Rezzonics/NuTubeAmp/NuTubeAmp_1_0_MS_tube_MouserOrder.txt

642-GH36P010001|2
81-GRM39X104K50D|2
81-GRM188R71C474KA88|2
667-ERJ-2GE0R00X|2
667-ERJ-6GEY0R00V|1
81-GRM21BR6YA106KE3L|1
667-ERJ-2GE0R00X|2
667-ERJ-2RKF1004X|16
667-ERJ-3EKF1001V|1
810-C1608X5R1H105K|18
667-ERJ-PA3F2201V|1
667-ERJ-2RKF4701X|2
667-ERJ-2RKF4701X|1
71-CRCW060310R0FKEAH|3
652-CR0603-FX1002HLF|2
667-ERJ-2RKF1002X|2
81-GRM21BR6YA106KE3L|16
652-SRN4018-100M|1
*|1 *** ERROR : V1
667-ERJ-3EKF2002V|2
810-C2012X5R1V226MAC|1
502-35RAPC4BHN2|1
81-GRM155R71H473KE4D|1
667-EEE-HBC470UAR|2
667-ERJ-2RKF5602X|1
875-HI0805R800R-10|2
667-ERJ-2RKF8202X|1
667-ERJ-3EKF8202V|3
667-ERJ-2RKF1000X|4
667-EEE-1VA101XP|2
667-ERJ-2RKF1003X|7
667-ERJ-3EKF1003V|3
667-EEE-1VA101XP|2
652-SRN1060-101M|1
81-GRM188R71C184KA1D|1
81-GRM155C1H271JA01D|1
667-ERJ-PA3F3000V|1
667-ERJ-2GEJ434X|1
81-GRM1885C1H102FA1D|6
696-SSL-LX5093GD|1
696-SSL-LX5093USBD|1
652-3314G-1-105E|1
652-3310Y-001-102L|1
652-3310Y-001-103L|1
652-3314G-2-103E|2
652-3310H-001-104L|1
652-3310Y-001-204L|2
652-3310Y-001-504L|2
81-BLM31PG121SN1L|1
642-MHS122K|1
642-MHS122K|1
490-PJ-202A|1
*|3 *** ERROR : JP3/JP4/JP5
926-LME49723MA/NOPB|1
534-1249|4
512-MMBF4117|10
550-12202|3
*|2 *** ERROR : H1/H3
*|4 *** ERROR : H2/H4/H6/H7
652-3314G-1-504E|2
810-C1608X5R1H105K|4
667-ERJ-2RKF1002X|2
667-ERJ-3EKF2400V|2
81-GRM21BR6YA106KE3L|2
*|1 *** ERROR : U1
595-TPA3112D1PWP|1
595-TPA6111A2D|1
595-TPS62175DQCR|1
*|22 *** ERROR : TP1/TP2/TP3/TP4/TP5/TP6/TP7/TP8/TP9/TP10/TP11/TP12/TP13/TP14/TP15/TP16/TP17/TP18/TP19/TP20/TP21/TP22
649-77311-401-36LF|1
649-77311-401-36LF|1
