Rezzonics/NuTubeAmp/NuTubeAmp_1_0_1.brd

## EAGLE design NuTubeAmp_1_0_1.brd (2018-03-24)

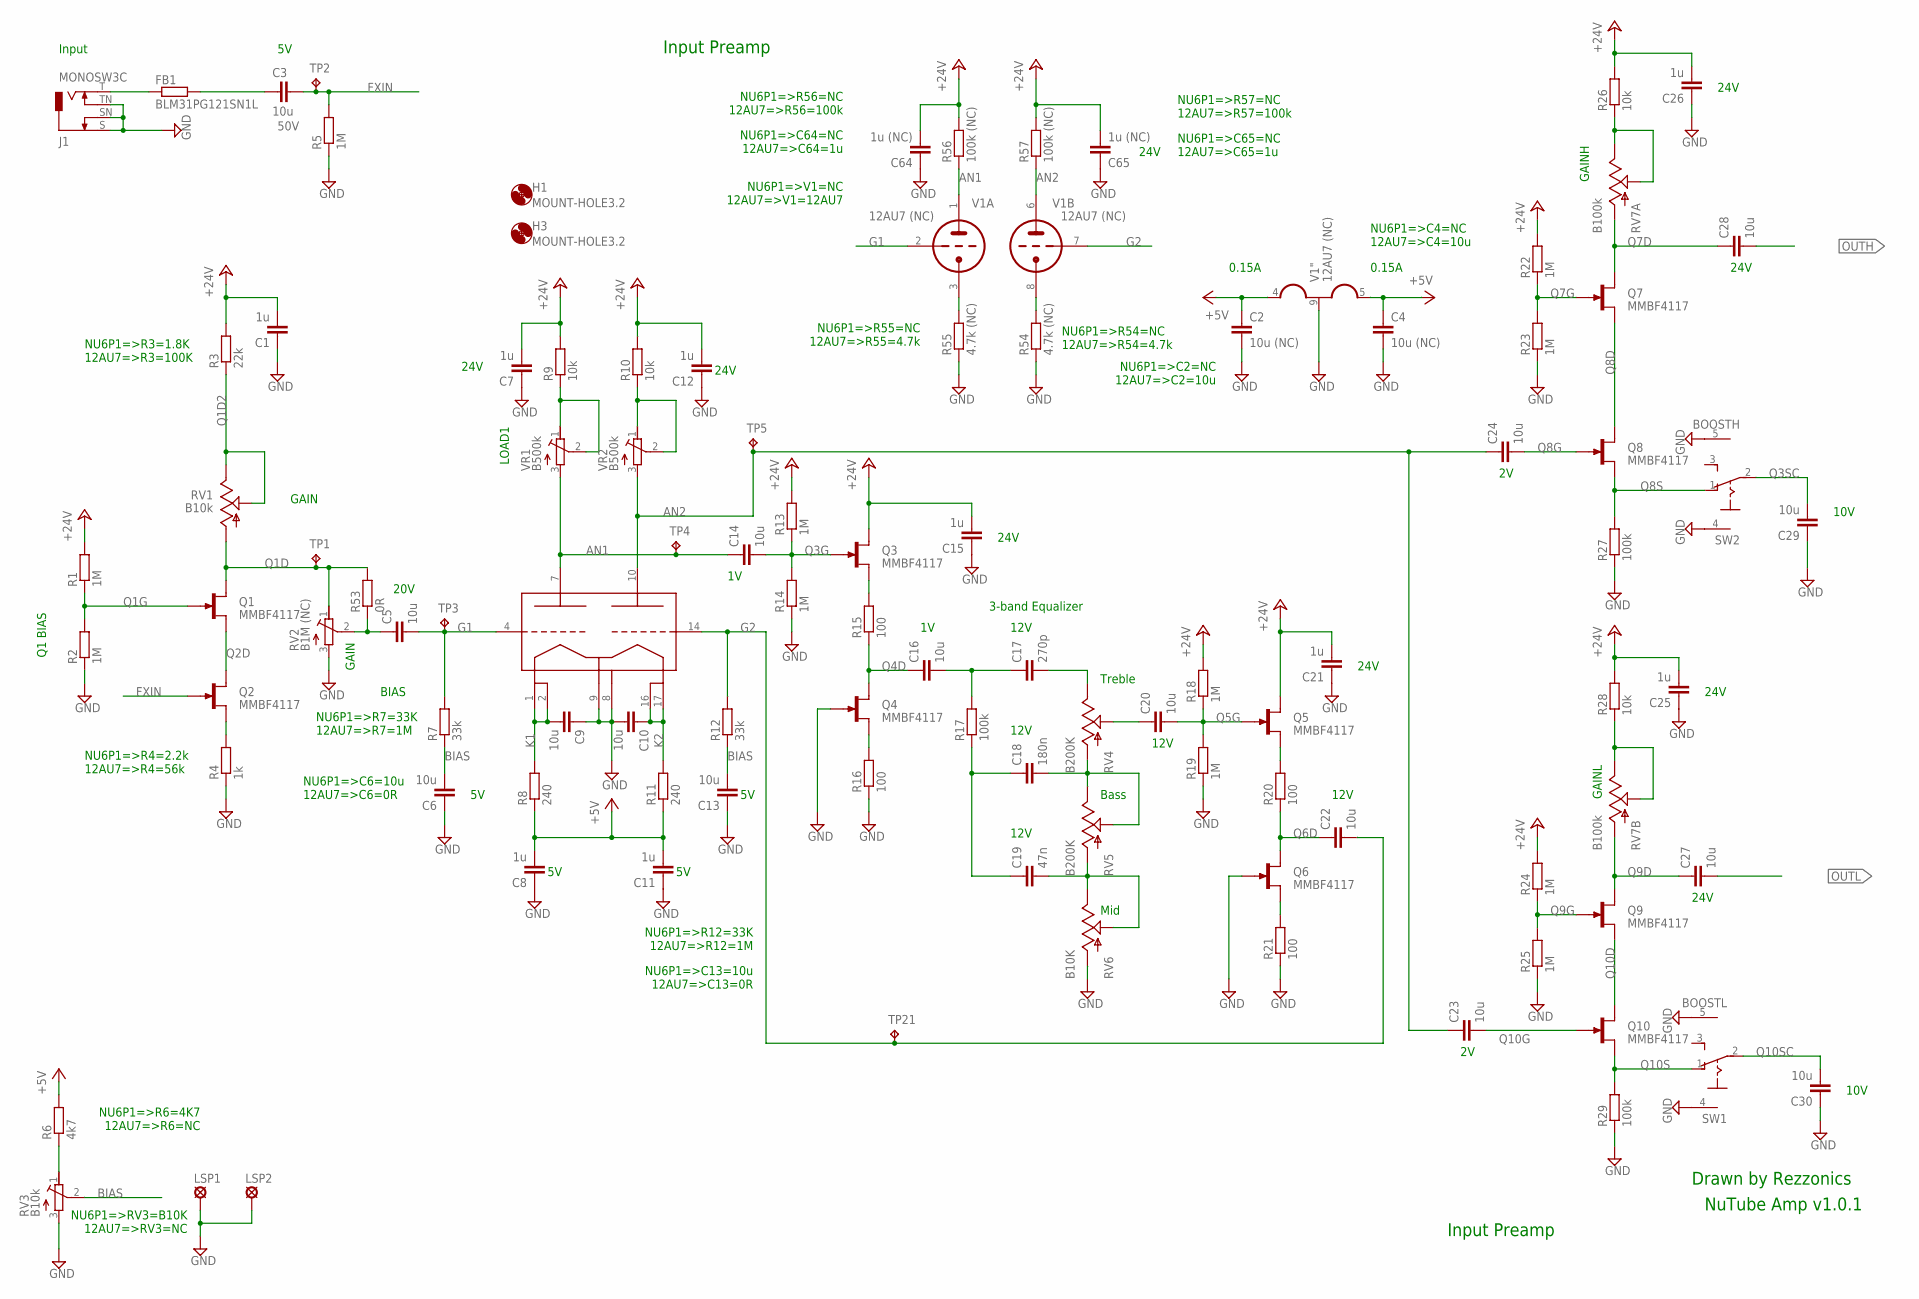
[picture p1: schematic NuTubeAmp_1_0_1.sch, sheet 1]

Parts:
C1, C7, C8, C11, C12, C15, C21, C25, C26: 1u; C0603K; MPN C1608X5R1H105K080AB
C2, C4: 10u (NC); C0805K; MPN GRM21BR6YA106KE43L
C3, C5, C6, C9, C10, C13, C14, C16, C20, C22, C23, C24, C27, C28, C29, C30: 10u; C0805K; MPN GRM21BR6YA106KE43L
C17: 270p; C0402K; MPN GRM1555C1H271JA01D
C18: 180n; C0603K; MPN GRM188R71C184KA01D
C19: 47n; C0402K; MPN GRM155R71H473KE14D
C64, C65: 1u (NC); C0603K; MPN C1608X5R1H105K080AB
FB1: BLM31PG121SN1L; R1206; MPN BLM31PG121SN1L
H1, H3: MOUNT-HOLE3.2; 3,2; MPN *
J1: MONOSW3C; NEUTRIK-NMJ4HCD2; MPN NMJ4HCD2
LSP1, LSP2: LSP13; MPN 1249
Q1, Q2, Q3, Q4, Q5, Q6, Q7, Q8, Q9, Q10: MMBF4117; SOT23; MPN MMBF4117
R1, R2, R5, R13, R14, R18, R19, R22, R23, R24, R25: 1M; R0402; MPN ERJ-2RKF1004X
R3: 22k; R0402; MPN ERJ-2RKF1801X
R4: 1k; R0402; MPN ERJ-2RKF2201X
R6: 4k7; R0402; MPN ERJ-2RKF4701X
R7, R12: 33k; R0402; MPN ERJ-2RKF3302X
R8, R11: 240; R0603; MPN ERJ-3EKF2400V
R9, R10, R26, R28: 10k; R0402; MPN ERJ-2RKF1002X
R15, R16, R20, R21: 100; R0402; MPN ERJ-2RKF1000X
R17, R27, R29: 100k; R0402; MPN ERJ-2RKF1003X
R53: 0R; R0402; MPN ERJ-2GE0R00X
R54, R55: 4.7k (NC); R0402; MPN ERJ-2RKF4701X
R56, R57: 100k (NC); R0402; MPN ERJ-2RKF1003X
RV1: B10k; 3310Y; MPN 3310Y-001-103L
RV2: B1M (NC); RTRIM3314G; MPN 3314G-1-105E
RV3: B10k; RTRIM3314G; MPN 3314G-2-103E
RV4, RV5: B200K; 3310Y; MPN 3310Y-001-204L
RV6: B10K; 3310Y; MPN 3310Y-001-103L
RV7: B100k; 3310H; MPN 3310H-001-104L
SW1: BOOSTL; MHS122K; MPN MHS122K
SW2: BOOSTH; MHS122K; MPN MHS122K
TP1, TP2, TP3, TP4, TP5, TP21: TPTP10R; TP10R; MPN *
U1: NUTUBE 6P1; NUTUBE_6P1_1; MPN *
V1: 12AU7 (NC); VT9; MPN *
VR1, VR2: B500k; RTRIM3314G; MPN 3314G-1-504E

Connections:
+5V: C2.1, C4.1, C8.2, C11.2, R6.2, R8.1, R11.1, V1.4 (H1), V1.5 (H3); also elsewhere on the board
+24V: C1.2, C7.2, C12.2, C15.2, C21.2, C25.2, C26.2, C64.2, C65.2, Q3.1 (D), Q5.1 (D), R1.2, R3.2, R9.2, R10.2, R13.2, R18.2, R22.2, R24.2, R26.2, R28.2, R56.2, R57.2; also elsewhere on the board
AN1: C14.1, R56.1, TP4.TP, U1.7 (A1_7), V1.1 (TA), VR1.3 (A)
AN2: C23.1, C24.1, R57.1, TP5.TP, U1.10 (A2_10), V1.6 (TA), VR2.3 (A)
BAST: C18.2, RV4.P$1 (A), RV5.P$2 (S), RV5.P$3 (E)
BIAS: C6.2, C13.2, R7.1, R12.1, RV3.2 (S)
EQIN: C16.2, C17.1, R17.2
EQOUT: C20.1, RV4.P$2 (S)
FXIN: C3.2, Q2.2 (G), R5.2, TP2.TP
G1: C5.2, R7.2, TP3.TP, U1.4 (G1_4), V1.2 (TG)
G2: C22.2, R12.2, TP21.TP, U1.14 (G2_14), V1.7 (TG)
G2TOP: R55.2, V1.3 (TK)
G3TOP: R26.1, RV7.P$2 (S), RV7.P$3 (E)
G4TOP: R28.1, RV7.P$5 (S), RV7.P$6 (E)
GND: C1.1, C2.2, C4.2, C6.1, C7.1, C8.1, C9.1, C10.2, C11.1, C12.1, C13.1, C15.1, C21.1, C25.1, C26.1, C29.1, C30.1, C64.1, C65.1, J1.S, J1.SN, J1.TN, LSP1.MP, LSP2.MP, Q4.2 (G), Q6.2 (G), R2.1, R4.1, R5.1, R14.1, R16.1, R19.1, R21.1, R23.1, R25.1, R27.1, R29.1, R54.1, R55.1, RV2.3 (A), RV3.3 (A), RV6.P$1 (A), SW1.4 (G1), SW1.5 (G2), SW2.4 (G1), SW2.5 (G2), U1.8 (GND_8), U1.9 (F2_9), V1.9 (H2); also elsewhere on the board
GTOP: C5.1, R53.1, RV2.2 (S)
K1: C9.2, R8.2, U1.1 (F1_1), U1.2 (F1_2)
K2: C10.1, R11.2, U1.16 (F3_16), U1.17 (F3_17)
MIDT: C19.2, RV5.P$1 (A), RV6.P$2 (S), RV6.P$3 (E)
unnamed: FB1.1, J1.T
unnamed: C3.1, FB1.2
unnamed: Q3.3 (S), R15.2
unnamed: R6.1, RV3.1 (E)
unnamed: R54.2, V1.8 (TK)
unnamed: C18.1, C19.1, R17.1
OUTH: C28.2; also elsewhere on the board
OUTL: C27.2; also elsewhere on the board
Q1D: Q1.1 (D), R53.2, RV1.P$1 (A), RV2.1 (E), TP1.TP
Q1D2: R3.1, RV1.P$2 (S), RV1.P$3 (E)
Q1G: Q1.2 (G), R1.1, R2.2
Q1S: Q2.3 (S), R4.2
Q1S1: Q4.3 (S), R16.2
Q1S2: Q6.3 (S), R21.2
Q2D: Q1.3 (S), Q2.1 (D)
Q3G: C14.2, Q3.2 (G), R13.1, R14.2
Q3SC: C29.2, SW2.2
Q4D: C16.1, Q4.1 (D), R15.1
Q5G: C20.2, Q5.2 (G), R18.1, R19.2
Q5S: Q5.3 (S), R20.2
Q6D: C22.1, Q6.1 (D), R20.1
Q7D: C28.1, Q7.1 (D), RV7.P$1 (A)
Q7G: Q7.2 (G), R22.1, R23.2
Q8D: Q7.3 (S), Q8.1 (D)
Q8G: C24.2, Q8.2 (G)
Q8S: Q8.3 (S), R27.2, SW2.1 (O)
Q9D: C27.1, Q9.1 (D), RV7.P$4 (A)
Q9G: Q9.2 (G), R24.1, R25.2
Q10D: Q9.3 (S), Q10.1 (D)
Q10G: C23.2, Q10.2 (G)
Q10S: Q10.3 (S), R29.2, SW1.1 (O)
Q10SC: C30.2, SW1.2
RL1: R9.1, VR1.1 (E), VR1.2 (S)
RL2: R10.1, VR2.1 (E), VR2.2 (S)
TBT: C17.2, RV4.P$3 (E)

Notes on the sheet:
NuTube Amp v1.0.1
Drawn by Rezzonics
Input Preamp
Treble
3-band Equalizer
Bass
Input
GAIN
Q1 BIAS
Mid
20V
24V
12V
10V
LOAD1
GAINH
GAINL
NU6P1=>R7=33K 12AU7=>R7=1M
BIAS
0.15A
NU6P1=>R3=1.8K 12AU7=>R3=100K
NU6P1=>R4=2.2k 12AU7=>R4=56k
NU6P1=>C6=10u 12AU7=>C6=0R
NU6P1=>V1=NC 12AU7=>V1=12AU7
NU6P1=>C64=NC 12AU7=>C64=1u
NU6P1=>R56=NC 12AU7=>R56=100k
NU6P1=>R57=NC 12AU7=>R57=100k
NU6P1=>C65=NC 12AU7=>C65=1u
NU6P1=>R55=NC 12AU7=>R55=4.7k
NU6P1=>R54=NC 12AU7=>R54=4.7k
NU6P1=>C2=NC 12AU7=>C2=10u
NU6P1=>C4=NC 12AU7=>C4=10u
NU6P1=>R12=33K 12AU7=>R12=1M
NU6P1=>C13=10u 12AU7=>C13=0R
NU6P1=>R6=4K7 12AU7=>R6=NC
NU6P1=>RV3=B10K 12AU7=>RV3=NC

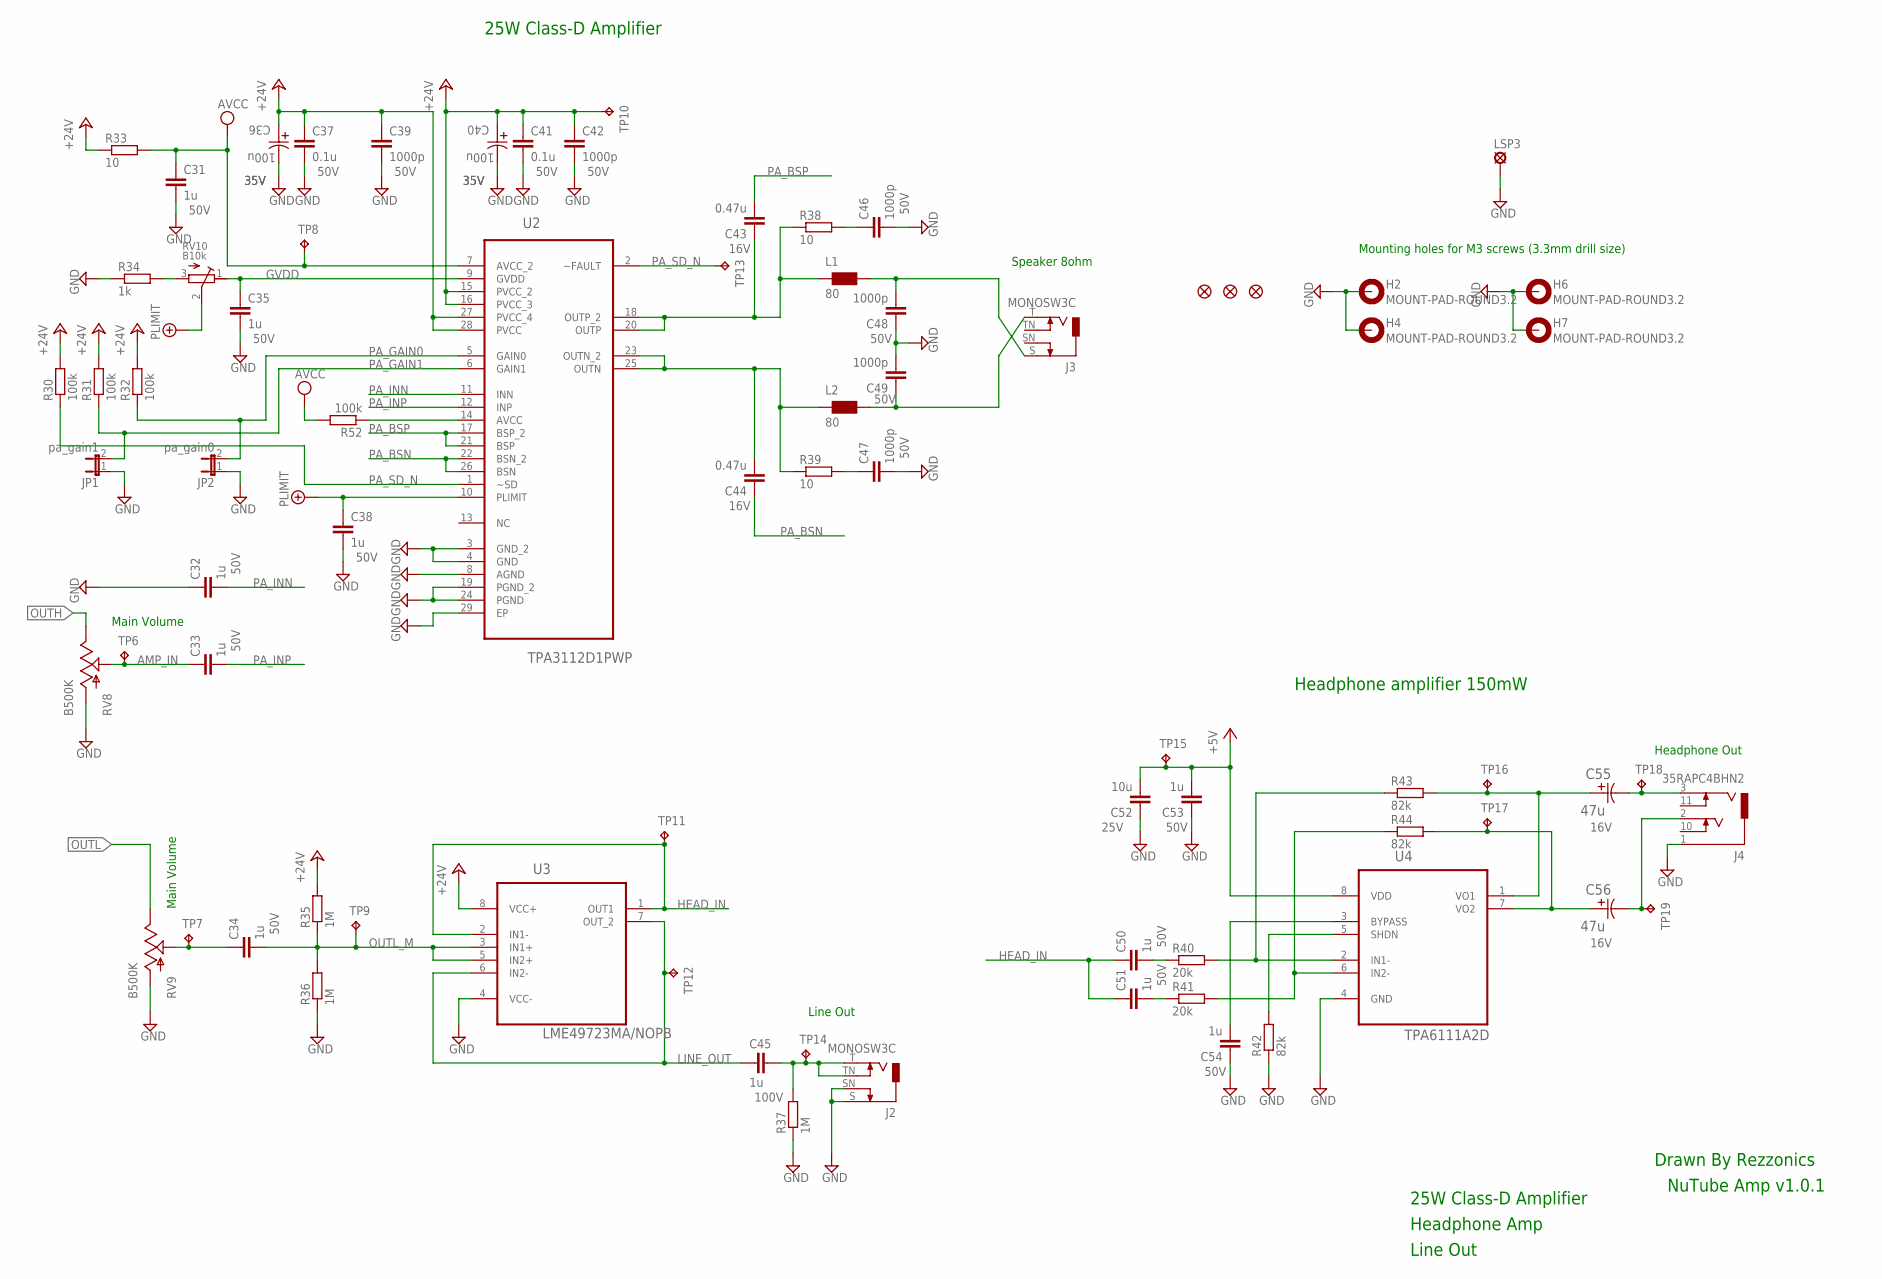
[picture p2: schematic NuTubeAmp_1_0_1.sch, sheet 2]

Parts:
C31, C32, C33, C34, C35, C38, C45, C50, C51, C53, C54: 1u; C0603K; MPN C1608X5R1H105K080AB
C36, C40: 100u; CAPAE660X800N; VOLTAGERATING 35V; MPN EEE-1VA101XP
C37, C41: 0.1u; C0603K; MPN GRM188R71H104KA93D
C39, C42, C46, C47, C48, C49: 1000p; C0603K; MPN GRM1885C1H102FA01D
C43, C44: 0.47u; C0603K; MPN GRM188R71C474KA88D
C52: 10u; C0805K; MPN GRM21BR6YA106KE43L
C55, C56: 47u; CAPAE530X610N; MPN EEE-HBC470UAR
H2, H4, H6, H7: MOUNT-PAD-ROUND3.2; 3,2-PAD; MPN *
J2, J3: MONOSW3C; NEUTRIK-NMJ4HCD2; MPN NMJ4HCD2
J4: 35RAPC4BHN2; MPN 35RAPC4BHN2
JP1: pa_gain1; 1X02; MPN 77311-401-36LF
JP2: pa_gain0; 1X02; MPN 77311-401-36LF
JP3, JP4, JP5: FIDUCIAL1X2.5; FIDUCIAL-1X2.5; MPN *
L1, L2: 80; 0805; MPN HI0805R800R-10
LSP3: LSP13; MPN 1249
R30, R31, R32, R52: 100k; R0603; MPN ERJ-3EKF1003V
R33, R38, R39: 10; R0603; MPN CRCW060310R0FKEAHP
R34: 1k; R0603; MPN ERJ-3EKF1001V
R35, R36, R37: 1M; R0402; MPN ERJ-2RKF1004X
R40, R41: 20k; R0603; MPN ERJ-3EKF2002V
R42, R43, R44: 82k; R0603; MPN ERJ-3EKF8202V
RV8, RV9: B500K; 3310Y; MPN 3310Y-001-504L
RV10: B10k; RTRIM3314G; MPN 3314G-2-103E
TP6, TP7, TP8, TP9, TP10, TP11, TP12, TP13, TP14, TP15, TP16, TP17, TP18, TP19: TPTP10R; TP10R; MPN *
U2: TPA3112D1PWP; SOP65P640X120-29N; MPN TPA3112D1PWP
U3: LME49723MA/NOPB; SOIC127P600X175-8N; MPN LME49723MA/NOPB
U4: TPA6111A2D; SOIC127P600X175-8N; MPN TPA6111A2D

Connections:
+5V: C52.2, C53.2, TP15.TP, U4.8 (VDD); also elsewhere on the board
+24V: C36.1, C37.1, C39.1, C40.1, C41.1, C42.1, R30.2, R31.2, R32.2, R33.1, R35.2, TP10.TP, U2.15 (PVCC_2), U2.16 (PVCC_3), U2.27 (PVCC_4), U2.28 (PVCC), U3.8 (VCC+); also elsewhere on the board
+UB: C38.1, RV10.2 (S), U2.10 (PLIMIT)
AMP_IN: C33.1, RV8.P$2 (S), TP6.TP
GND: C31.2, C32.1, C35.2, C36.2, C37.2, C38.2, C39.2, C40.2, C41.2, C42.2, C46.2, C47.2, C48.1, C49.2, C52.1, C53.1, C54.1, H2.B3,2, H4.B3,2, H6.B3,2, H7.B3,2, J2.S, J2.SN, J4.1 (S), JP1.1, JP2.1, LSP3.MP, R34.1, R36.1, R37.1, R42.1, RV8.P$1 (A), RV9.P$1 (A), U2.3 (GND_2), U2.4 (GND), U2.8 (AGND), U2.19 (PGND_2), U2.24 (PGND), U2.29 (EP), U3.4 (VCC-), U4.4 (GND); also elsewhere on the board
GVDD: C35.1, RV10.1 (E), U2.9 (GVDD)
HEAD_IN: C50.1, C51.1, TP11.TP, U3.1 (OUT1), U3.2 (IN1-)
LINE_OUT: C45.1, TP12.TP, U3.6 (IN2-), U3.7 (OUT_2)
unnamed: R40.2, R43.1, U4.2 (IN1-)
unnamed: R52.1, U2.14 (AVCC)
unnamed: R41.2, R44.1, U4.6 (IN2-)
unnamed: C55.1, R43.2, TP16.TP, U4.1 (VO1)
unnamed: C34.1, RV9.P$2 (S), TP7.TP
unnamed: C56.1, R44.2, TP17.TP, U4.7 (VO2)
unnamed: C50.2, R40.1
unnamed: C51.2, R41.1
unnamed: C54.2, U4.3 (BYPASS)
unnamed: R42.2, U4.5 (SHDN)
unnamed: C55.2, J4.3 (R), TP18.TP
unnamed: C56.2, J4.2 (T), TP19.TP
unnamed: C45.2, J2.T, J2.TN, R37.2, TP14.TP
unnamed: C46.1, R38.2
unnamed: C47.1, R39.2
unnamed: R34.2, RV10.3 (A)
unnamed: C49.1, J3.T, L2.2
unnamed: C48.2, J3.S, L1.2
unnamed: C43.1, L1.1, R38.1, U2.18 (OUTP_2), U2.20 (OUTP)
unnamed: C44.2, L2.1, R39.1, U2.23 (OUTN_2), U2.25 (OUTN)
OUTH: RV8.P$3 (E); also elsewhere on the board
OUTL: RV9.P$3 (E); also elsewhere on the board
OUTL_M: C34.2, R35.1, R36.2, TP9.TP, U3.3 (IN1+), U3.5 (IN2+)
PA_BSN: C44.1, U2.22 (BSN_2), U2.26 (BSN)
PA_BSP: C43.2, U2.17 (BSP_2), U2.21 (BSP)
PA_GAIN0: JP2.2, R32.1, U2.5 (GAIN0)
PA_GAIN1: JP1.2, R31.1, U2.6 (GAIN1)
PA_INN: C32.2, U2.11 (INN)
PA_INP: C33.2, U2.12 (INP)
PA_SD_N: R30.1, TP13.TP, U2.1 (~SD), U2.2 (~FAULT)
VCC: C31.1, R33.2, R52.2, TP8.TP, U2.7 (AVCC_2)

Notes on the sheet:
Drawn By Rezzonics
NuTube Amp v1.0.1
Speaker 8ohm
25W Class-D Amplifier
Mounting holes for M3 screws (3.3mm drill size)
Headphone amplifier 150mW
Headphone Out
Main Volume
Headphone Amp
Line Out

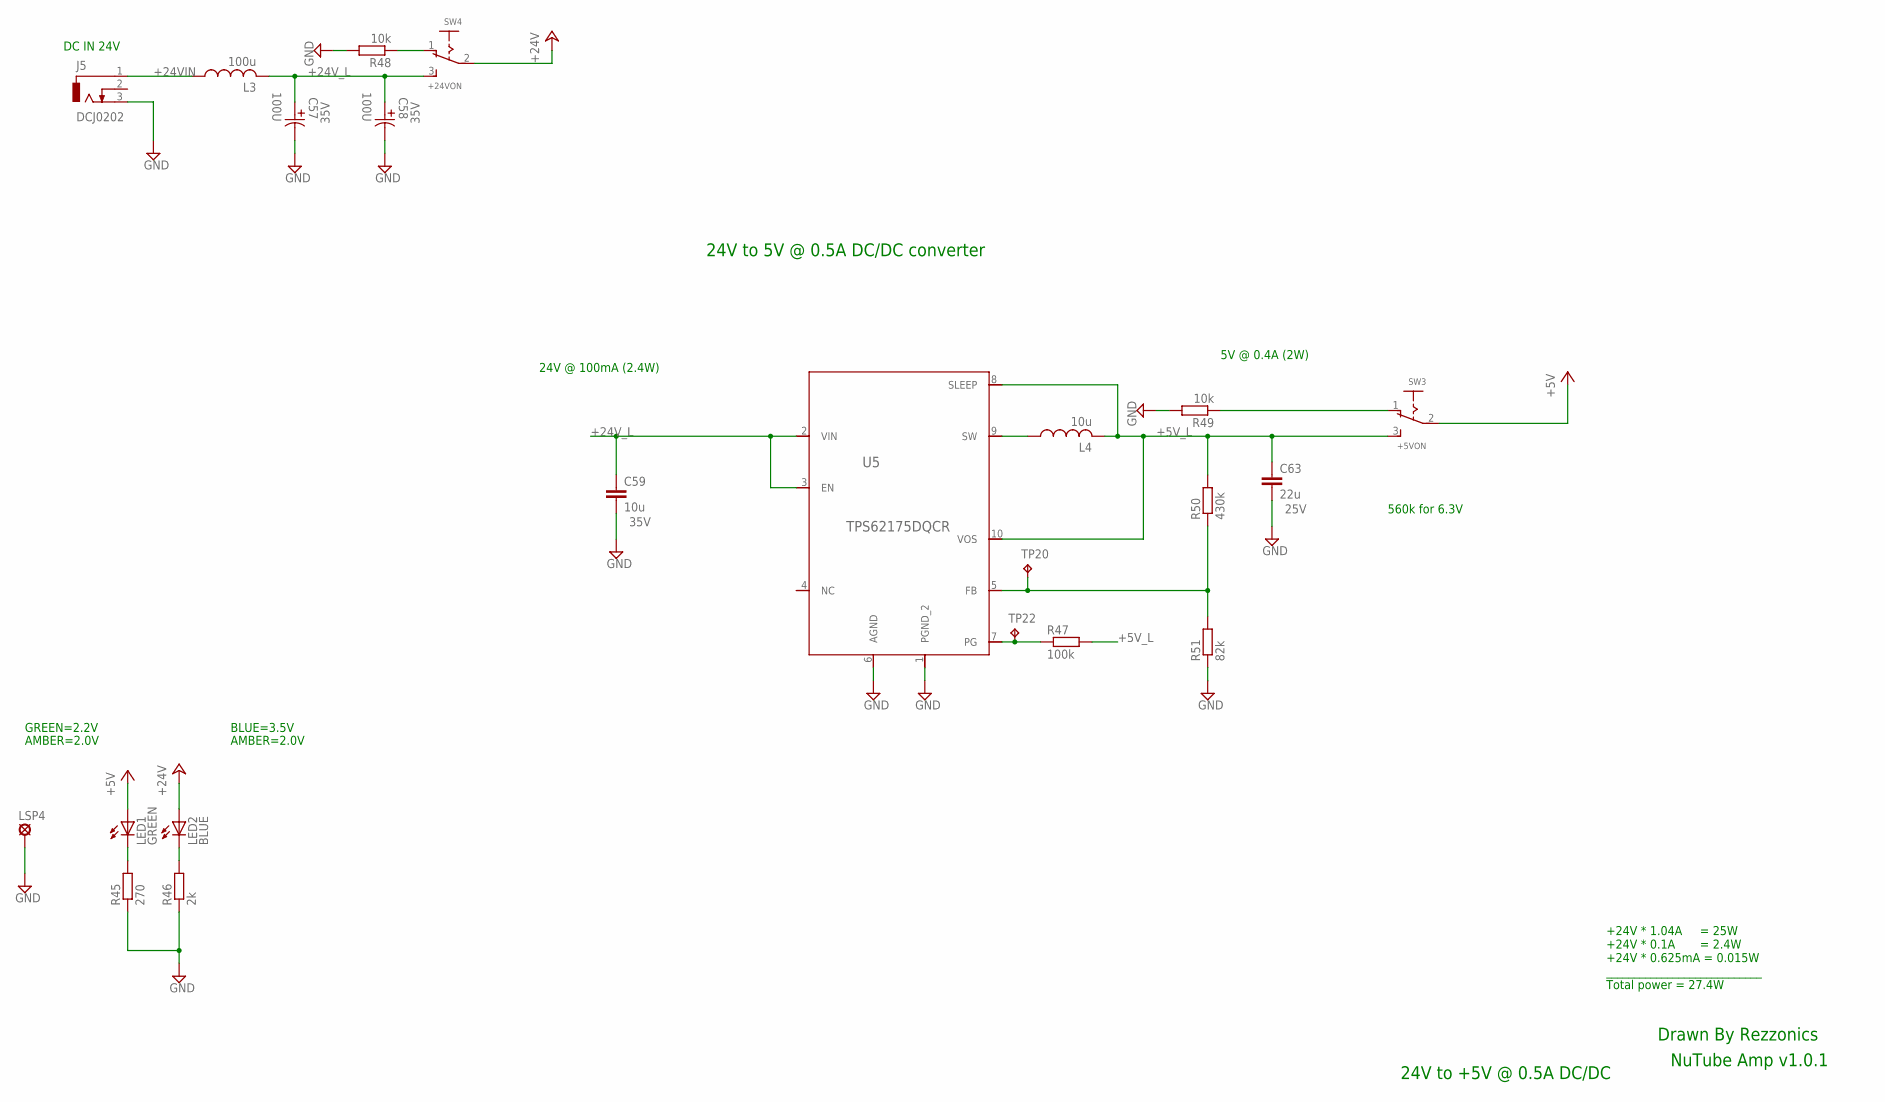
[picture p3: schematic NuTubeAmp_1_0_1.sch, sheet 3]

Parts:
C57, C58: 100U; CAPAE660X800N; VOLTAGERATING 35V; MPN EEE-1VA101XP
C59: 10u; C0805K; MPN GRM21BR6YA106KE43L
C63: 22u; C0805K; MPN C2012X5R1V226M125AC
J5: DCJ0202; MPN PJ-202A
L3: 100u; SRN1060; MPN SRN1060-101M
L4: 10u; SRN4018; MPN SRN4018-100M
LED1: GREEN; LED5MM; MPN SSL-LX5093GD
LED2: BLUE; LED5MM; MPN SSL-LX5093USBD
LSP4: LSP13; MPN 1249
R45: 270; R0603; MPN ERJ-PA3F2700V
R46: 2k; R0603; MPN ERJ-PA3F2001V
R47: 100k; R0402; MPN ERJ-2RKF1003X
R48, R49: 10k; R0603; MPN CR0603-FX-1002HLF
R50: 430k; R0402; MPN ERJ-2GEJ434X
R51: 82k; R0402; MPN ERJ-2RKF8202X
SW3: +5VON; GH39P0; MPN GH36P010001
SW4: +24VON; GH39P0; MPN GH36P010001
TP20, TP22: TPTP10R; TP10R; MPN *
U5: TPS62175DQCR; R-PWSON-N10; MPN TPS62175DQCR

Connections:
+5V: LED1.A, SW3.2; also elsewhere on the board
+5V_L: C63.1, L4.2, R47.2, R50.2, SW3.3 (S), U5.8 (SLEEP), U5.10 (VOS)
+24V: LED2.A, SW4.2; also elsewhere on the board
+24VIN: J5.1, L3.1
+24V_L: C57.1, C58.1, C59.1, L3.2, SW4.3 (S), U5.2 (VIN), U5.3 (EN)
GND: C57.2, C58.2, C59.2, C63.2, J5.3, LSP4.MP, R45.1, R46.1, R48.2, R49.2, R51.1, U5.1 (PGND_2), U5.6 (AGND); also elsewhere on the board
unnamed: R47.1, TP22.TP, U5.7 (PG)
unnamed: R48.1, SW4.1 (O)
unnamed: R49.1, SW3.1 (O)
unnamed: L4.1, U5.9 (SW)
unnamed: LED1.K (C), R45.2
unnamed: LED2.K (C), R46.2
VCC3: R50.1, R51.2, TP20.TP, U5.5 (FB)

Notes on the sheet:
24V @ 100mA (2.4W)
24V to 5V @ 0.5A DC/DC converter
5V @ 0.4A (2W)
Drawn By Rezzonics
NuTube Amp v1.0.1
24V to +5V @ 0.5A DC/DC
+24V * 1.04A = 25W +24V * 0.1A = 2.4W +24V * 0.625mA = 0.015W ____________________________ Total power = 27.4W
DC IN 24V
560k for 6.3V
GREEN=2.2V
BLUE=3.5V
AMBER=2.0V

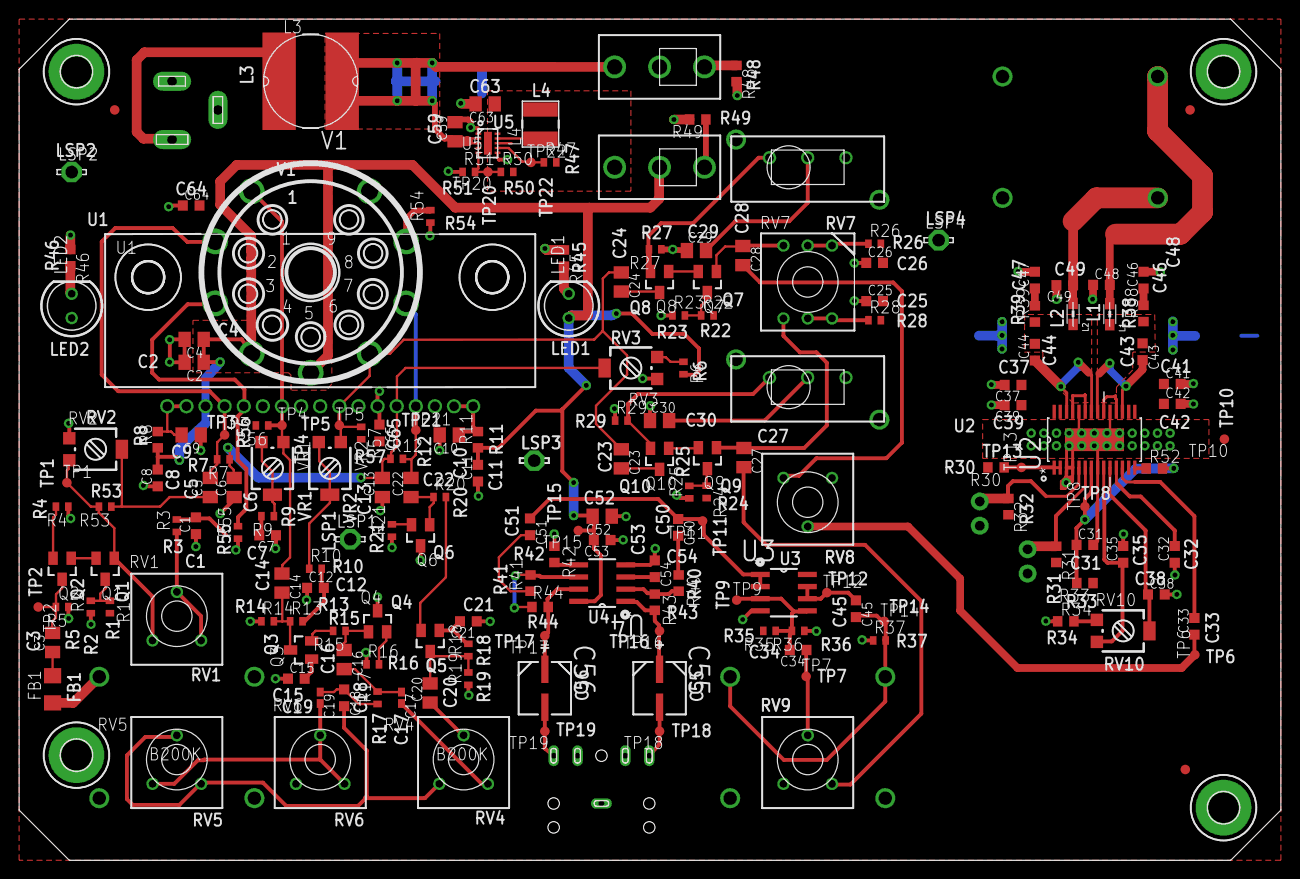
[picture p4: board NuTubeAmp_1_0_1.brd from above]

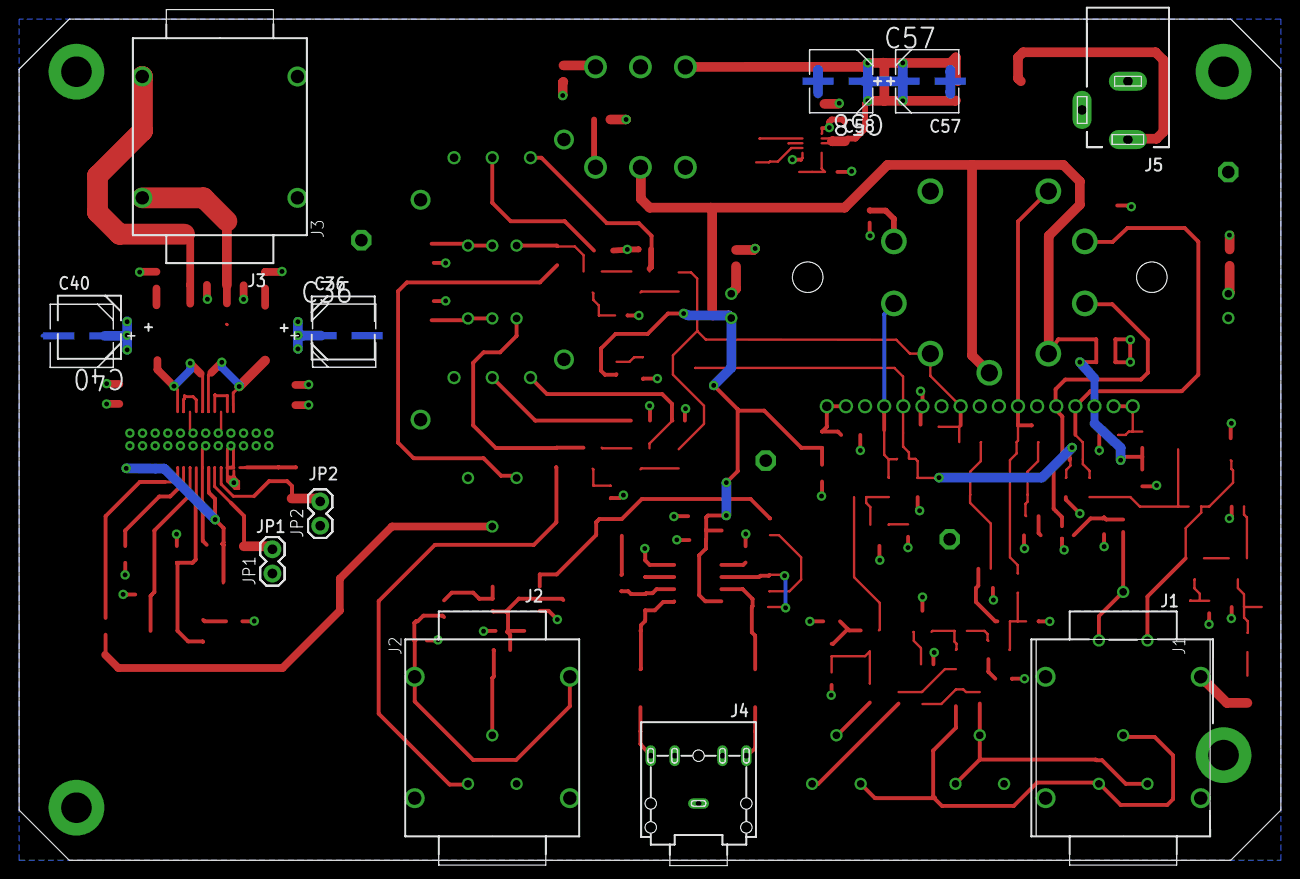
[picture p5: board NuTubeAmp_1_0_1.brd from below]

Board: 2 copper layers, 132.0 x 88.0 mm, 200 parts (11 on the bottom side), 98 nets.
